Smith-And-Rune/Iron165/README.md

# Iron165
Smith and Rune Iron 165 Keyboard
