Smith-And-Rune/Iron165/MasterPartsList.md

# Smith and Rune Master Parts List

1. [Iron165 Line](#iron165)
    1. [Iron165 FE](#iron165fe)
    2. [Iron165 SE](#iron165se)
    3. [Iron165](#iron165-2021)
2. [Iron180 Line](#iron180)
    1. [Iron180](#iron180-2020)

# Iron165 Line 
## Iron165 FE (Founder's Edition) 
#### Screws
| Part | Quantity | Screw | Bit Size |
| --- | :---: | :---: | :---: |
| Bottom to top | 8 | M2.5x6 SCS<sup>[1]</sup> | H2
| Badge | 2 | M2x4 SCS | H1.5
| Daughterboard | 4 | M2x4 SCS | H1.5

#### Accessories
| Part | Description | Notes |
| ---- | --- | --- |
| Bumpons | 4x 6mmx2mm adhesive feet | https://www.amazon.com/dp/B06XCNM69B
| Daughterboard | C2 unified daughterboard | C3 will work as well. Github: https://github.com/ai03-2725/Unified-Daughterboard
| Gaskets | 0.093" Custom cut poron | Sheets are purchaseable online, but will need to be cut into strips. Anything 1.5mm - 2.35mm will work as well

## Iron165 SE (2019) 
#### Screws
| Part | Quantity | Screw | Bit Size |
| --- | :---: | :---: | :---: |
| Bottom to top | 8 | M2.5x6 SCS<sup>[1]</sup> | H2
| Weight | 2 | M3x4 CSK<sup>[2]</sup> | Phillips #2
| Badge | 2 | M2x4 SCS | H1.5
| Daughterboard | 4 | M2x4 SCS | H1.5

#### Accessories
| Part | Description | Notes |
| ---- | --- | --- |
| Bumpons | 4x 6mmx2mm adhesive feet | https://www.amazon.com/dp/B06XCNM69B
| Daughterboard | C2 unified daughterboard | C3 will work as well. Github: https://github.com/ai03-2725/Unified-Daughterboard
| Gaskets | 0.093" Custom cut poron | Sheets are purchaseable online, but will need to be cut into strips. Anything 1.5mm - 2.35mm will work as well

## Iron165 (2021) 
#### Screws
| Part | Quantity | Screw | Bit Size |
| --- | :---: | :---: | :---: |
| Bottom to top | 8 | M2.5x10 SCS<sup>[1]</sup> | H2
| Rune logo | 3 | M2x3 PHS<sup>[3]</sup> | Phillips #1
| Daughterboard | 4 | M2x4 SCS | H1.5

##### Optional Screws
If you want the 4 screws in the back to sit flush with the bottom like the front screws

| Part | Quantity | Screw | Bit Size/Notes |
| --- | :---: | :---: | :---: |
| Flush back screws | 4 | M2.5x22 SCS<sup>[1]</sup> | H2
| Flush back spacers | 4 | M2.5x12 spacers | Outer diameter under 4.5mm

#### Accessories
| Part | Description | Notes |
| ---- | --- | --- |
| Bumpons | 4x 6mmx2mm adhesive feet | https://www.amazon.com/dp/B06XCNM69B
| Daughterboard | C3 unified daughterboard | C3 will work as well. Github: https://github.com/ai03-2725/Unified-Daughterboard
| Gaskets | 0.093" Custom cut poron | Sheets are purchaseable online, but will need to be cut into strips. Anything 1.5mm - 2.35mm will work as well

# Iron180 
## Iron180 (2020) 
#### Screws
| Part | Quantity | Screw | Bit Size/Notes |
| --- | :---: | :---: | :---: |
| Bottom to top | 8 | M2.5x10 SCS<sup>[1]</sup> | H2
| Rune logo | 3 | M2x3 PHS<sup>[3]</sup> | Phillips #1
| Daughterboard | 4 | M2x4 SCS | H1.5

##### Optional Screws
If you want the 4 screws in the back to sit flush with the bottom like the front screws

| Part | Quantity | Screw | Bit Size |
| --- | :---: | :---: | :---: |
| Flush back screws | 4 | M2.5x25 SCS<sup>[1]</sup> | H2
| Flush back spacers | 4 | M2.5x15 spacers | Outer diameter under 4.5mm

#### Accessories
| Part | Description | Notes |
| ---- | --- | --- |
| Bumpons | 4x 6mmx2mm adhesive feet | https://www.amazon.com/dp/B06XCNM69B
| Daughterboard | C3 unified daughterboard | https://github.com/ai03-2725/Unified-Daughterboard
| Gaskets | 0.093" Custom cut poron | Sheets are purchaseable online, but will need to be cut into strips. Anything 1.5mm - 2.35mm will work as well

<sup>[1]</sup>Socket cap screw

<sup>[2]</sup>Countersunk screw

<sup>[3]</sup>Pan head screw
