Smith-And-Rune/Iron165/build_guide_photos/parts.jpg

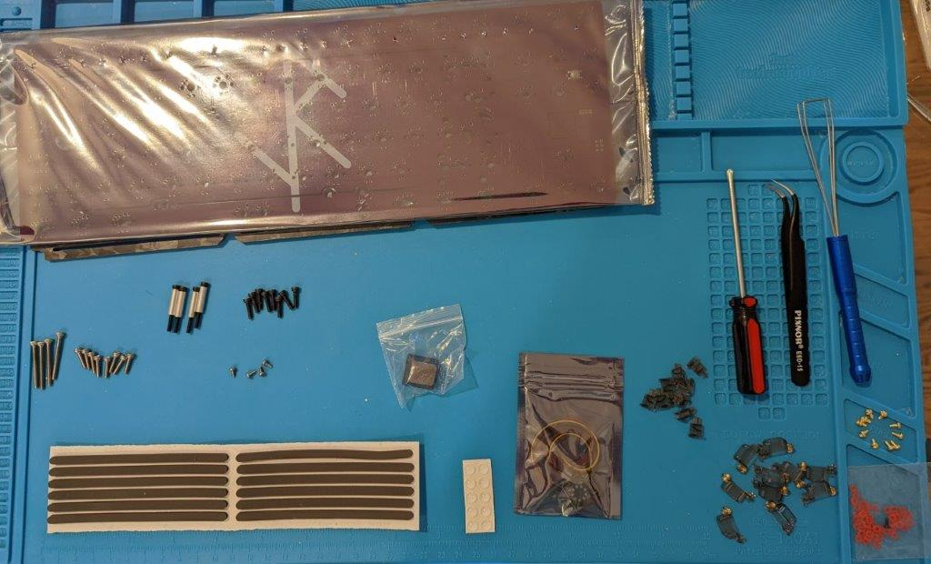
build_guide_photos/parts.jpg
