Smith-And-Rune/Iron165/Badges/Badge_SR_Logo.STEP

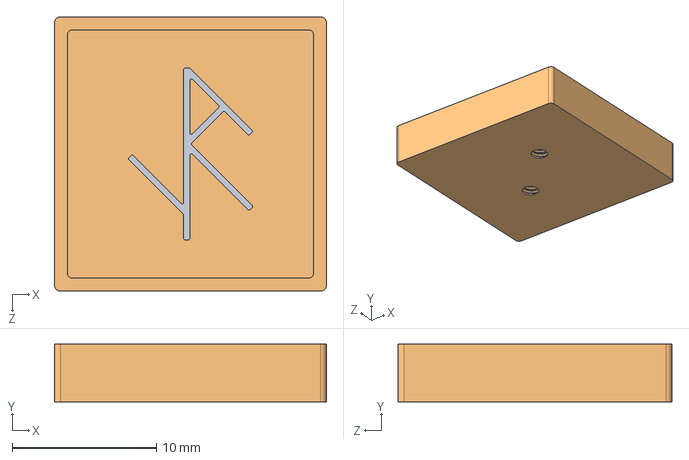
[picture p2: CAD file, 2021-02-24]
Badges/Badge_SR_Logo.STEP
18.8 x 4.00 x 19.0 mm
