Smith-And-Rune/Iron165/Round 1 Plates/Plate_Tsangan_Forced_Split_BS.STEP

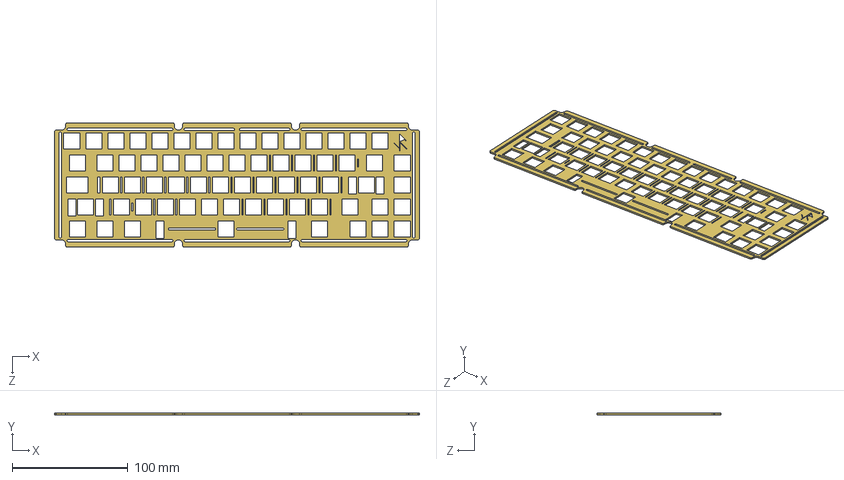
[picture p3: CAD file, 2022-06-17]
Round 1 Plates/Plate_Tsangan_Forced_Split_BS.STEP
315.7 x 1.50 x 107.7 mm
