Smith-And-Rune/Iron165/Round 2 Plates/Plate_ISO1.2.STEP

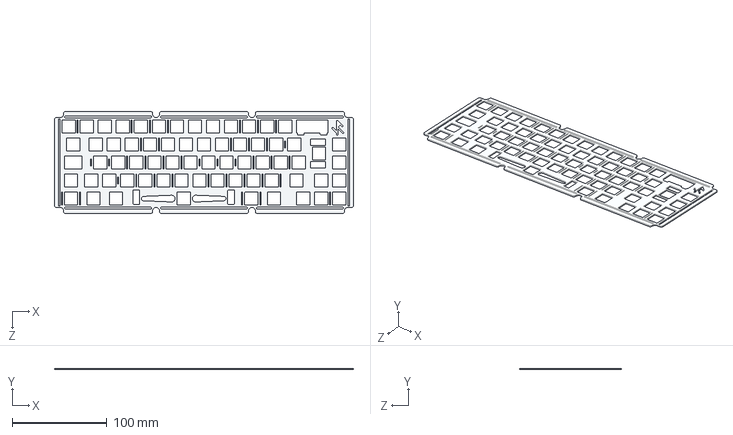
[picture p4: CAD file, 2022-10-20]
Round 2 Plates/Plate_ISO1.2.STEP
315.7 x 1.50 x 107.7 mm
