Smith-And-Rune/Iron165/Round 1 Plates/Iron165_Round1_Plate_ISO.DXF

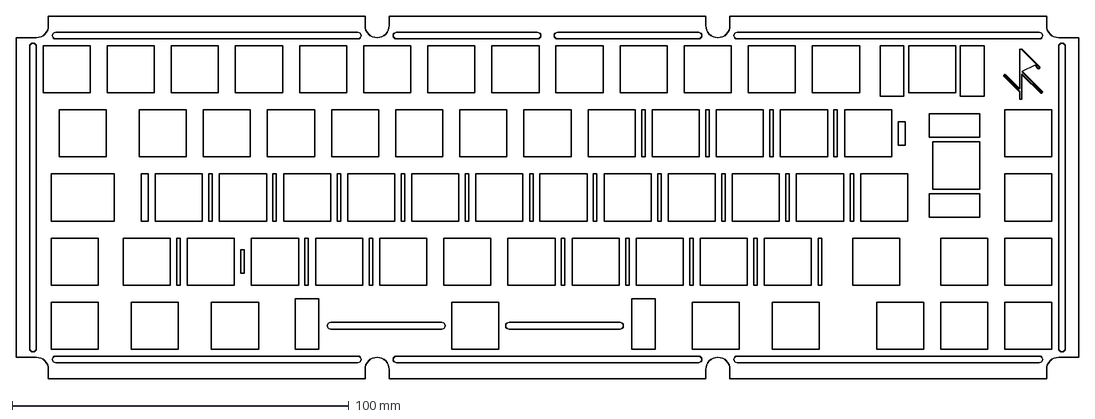
[picture p5: CAD file, 2020-07-20]
Round 1 Plates/Iron165_Round1_Plate_ISO.DXF
315.7 x 107.7 mm
