Smith-And-Rune/Iron165/(list of files, cad)

Other CAD files:
Badges/Badge_Blank.STEP
Round 1 Plates/Plate_ISO.STEP
Round 2 Plates/Plate_Tsangan1.2.STEP
Round 1 Plates/Plate_Tsangan.STEP
Round 2 Plates/Plate_ANSI1.2.STEP
Round 1 Plates/Plate_ANSI.STEP
Round 2 Plates/Plate_Tsangan1.2_PC.STEP
Round 2 Plates/Plate_ANSI1.2_PC.STEP
Round 1 Plates/Plate_ANSI.DXF
Round 1 Plates/Plate_ISO.DXF
Round 1 Plates/Plate_Tsangan.DXF
Round 1 Plates/Plate_Tsangan_Forced_Split_BS.DXF
