Smith-And-Rune/Iron165/build_guide_photos/remove_back_2.jpg

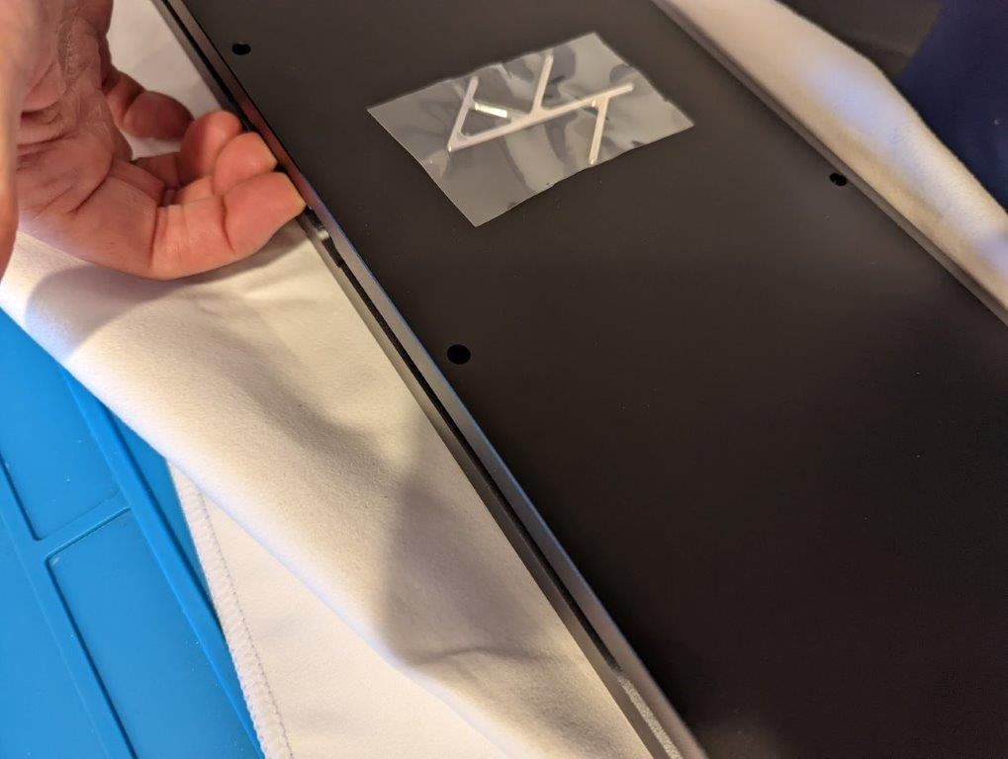
build_guide_photos/remove_back_2.jpg
