Smith-And-Rune/Iron165/(commit log)

2020-09-13 Added Master Screw List and Moved some of the files around
    [Badge_Blank.STEP, Plate_ANSI.DXF, Plate_ANSI.STEP, Plate_ISO.DXF, Plate_ISO.STEP, Plate_Tsangan.DXF, Plate_Tsangan.STEP, Plate_Tsangan_Forced_Split_BS.DXF]
2021-02-04 Added info on spacer OD
2021-02-24 Added Iron165 R2 render file and updated badge
    [Badge_SR_Logo.STEP, SR_Badge.STEP]
2021-03-26 reorganized files
    [Badge_Blank.STEP, Badge_SR_Logo.STEP, Iron165_Round1_Plate_ANSI.DXF, Iron165_Round1_Plate_ANSI.STEP, Iron165_Round1_Plate_ISO.DXF, Iron165_Round1_Plate_ISO.STEP, Iron165_Round1_Plate_Tsangan.DXF, Iron165_Round1_Plate_Tsangan.STEP]
2022-06-11 update r1 plate files and update gitignore
    [Iron165_Round1_Plate_ANSI.STEP, Iron165_Round1_Plate_ISO.STEP, Iron165_Round1_Plate_Tsangan.STEP, Iron165_Round1_Plate_Tsangan_Forced_Split_BS.STEP, Plate_ANSI.DXF, Plate_ANSI.STEP, Plate_ISO.DXF, Plate_ISO.STEP]
2022-08-08 upate quantity and type of screw
2022-10-20 add Iron165 v2 plate files.
    [Plate_ANSI1.2.STEP, Plate_ANSI1.2_PC.STEP, Plate_ISO1.2.STEP, Plate_Tsangan1.2.STEP, Plate_Tsangan1.2_PC.STEP]
